benediktibk/dcconverter/circuit_designs/dc_dc_converter.asc

C1: cap; 0.01; Rser=20m
C2: cap; 2.2p
C3: cap; 1µ
C4: cap; 10n
ContactWire: voltage; PULSE(0 1000 0.01 0 0 10 10 1)
Controller: voltage; PULSE(0 3.3 0 0 0 1.5u 10u)
ControllerGate: voltage; PULSE(0 3.3 0.02 0 0 1 1)
D1: schottky; RBR30T60A
D2: diode
D3: diode
D4: zener; 1N5378B
D5: zener; 1N5378B
D6: zener; 1N5378B
D7: zener; 1N5378B
L1-710-744839010400-Mouser: ind; 1m; Rser=2.1m
Load: res; 0.576
M1: nmos
M2: pmos
M3: nmos
M7: pmos; HAT1072H
OutputGate: voltage; PULSE(0 3.3 0.0187 0 0 1 1)
Q2: npn
Q3: npn
Q4: npn
R1: res; 220
R2: res; 1Meg
R3: res; 10Meg
R4: res; 220
R5: res; 1Meg
R6: res; 10k
R8: res; 220
R14: res; 900k
R15: res; 100k
Z1: NIGBT; irg4ph50s
Named nets: 0
.tran 0.1 startup
.inc irg4ph50s.spi
.inc sct2280ke.spi
.inc FQB1P50.spi
.inc FDPF3N50NZ.spi
.inc FQP3P50.spi
.inc C2M0280120D.spi
.inc OptiMOS3_250V_LTSpice.spi
.inc FDH15N50.spi
