benediktibk/dcconverter/circuit_designs/voltage_source_driver.asc

C2: cap; 100µ
ContactWire2: voltage; PULSE(0 300 0.1 0 0 10 10 1)
D3: diode; RR601BM4S
M2: nmos; STW11NM80
R1: res; 4700
R3: res; 10Meg
Named nets: 0
.tran 0 1 0 1u
