benediktibk/dcconverter/circuit_designs/high_side_switch.asc

M1: pmos; IRF7205
Q1: npn
R1: res; 10
R2: res; 220
R3: res; 1k
V1: voltage; 24
V2: voltage; PULSE(0 5 0.5 0 0 10 10)
Named nets: 0
.tran 5
