benediktibk/dcconverter/circuit_designs/recitifier.asc

C1: cap; 10m
C2: cap; 10m
D1: diode; RR1LAM6S
D2: diode; RR1LAM6S
D3: diode; RR1LAM6S
D4: diode; RR1LAM6S
D5: diode; RR1LAM6S
R1: res; 100m; pwr=1W
R2: res; 100
V1: voltage; SINE(0 325 50)
Named nets: 0
.tran .5
