benediktibk/dcconverter/circuit_designs/driver_prototype.asc

C1: cap; 550pF
Q1: npn; 2N2222
Q2: npn; 2N2222
Q3: npn; 2N2222
R1: res; 4.7k
R2: res; 220
R3: res; 4.7k
R4: res; 220
R5: res; 220
V1: voltage; 10
V2: voltage; PULSE(0 3.3 0.5 0 0 1 2)
V3: voltage; PULSE(0 3.3 5 0 0 5 10)
Named nets: 0
.tran 10
