benediktibk/dcconverter/circuit_designs/controller.asc

C4: cap; 2.2nF
ControllerVoltage1: voltage; PULSE(2.4 3 1m 1u 1u 1m 2m)
ControllerVoltage: voltage; 5
M8: nmos
M9: pmos
Q2: pnp; 2N3906
R2: res; 3k
R12: res; 680
R13: res; 1k
R16: res; 73k
U1: NE555
Named nets: 0
.tran 10m startup
