benediktibk/dcconverter/circuit_designs/igbt_gate_driver.asc

C1: cap; 1µ; Rser=1m
C2: cap; 1µ; Rser=1m
C3: cap; 1µ; Rser=1m
M1: nmos
M2: pmos
M3: nmos
M4: pmos
M5: nmos
M6: pmos
M7: nmos
M8: nmos
R1: res; 100
R3: res; 100
U1: 4N25
U2: 4N25
V1: voltage; 5
V2: voltage; PULSE(0 5 1 0 0 2 5)
V3: voltage; 100
V4: voltage; PULSE(0 5 1 0 0 2 5)
V5: voltage; 5
V6: voltage; 100
V7: voltage; PULSE(0 5 1 0 0 2 5)
V8: voltage; 5
Named nets: 0
.tran 20
