benediktibk/dcconverter/DcConverterControllerOptimization/CircuitSimulation/StepDownConverterRealisticValues.asc

C1: cap; 100µ
Controller: voltage; PULSE(0 17.7 0 0.001u 0.001u 0.1 0.1)
L1: ind; 0.002; Rser=0.4
Load: res; 10
Named nets: 0
.tran 0 10MS 0 1NS
.OPTIONS TRTOL=1
