benediktibk/dcconverter/DcConverterControllerOptimization/ConverterSimulationTest/StepDownConverterVersion1.asc

C1: cap; 100µ
Controller1: voltage; PULSE(0 -0.67 0 1n 1n 100m 100m)
Controller: voltage; PULSE(0 18.37 0 0.01u 0.01u 20u 134u)
L1: ind; 0.002; Rser=0.4
Load: res; 10
Named nets: 0
.tran 0 50MS 0 10NS
