benediktibk/dcconverter/DcConverterControllerOptimization/CircuitSimulation/StepDownConverter.asc

C1: cap; 220m
L1: ind; 900m
R1: res; 2
R2: res; 0.2
V1: voltage; PULSE(2.2 10 0 0.001 0.001 0.2 5)
Named nets: 0
.tran 0 5 0 0.0001
