benediktibk/dcconverter/DcConverterControllerOptimization/CircuitSimulation/ResistorInSeriesAndCapacitor.asc

C1: cap; 0.3
R1: res; 2
R2: res; 3
V1: voltage; PULSE(5 10 0 0)
Named nets: 0
.tran 0 5 0 0.01
