benediktibk/dcconverter/DcConverterControllerOptimization/CircuitSimulation/ResistorInSeriesAndInductance.asc

L1: ind; 900m
R1: res; 2
R2: res; 3
V1: voltage; PULSE(0 10 0 0)
Named nets: 0
.tran 0 5 0 0.001
