benediktibk/dcconverter/DcConverterControllerOptimization/CircuitSimulation/ResistorInSeries.asc

R1: res; 2
R2: res; 3
V1: voltage; 10
Named nets: 0
.tran 5
