benediktibk/dcconverter/pcbs/dcconverter/dcconverter.kicad_pcb

## KiCad design pcbs/dcconverter/dcconverter.kicad_pcb (2020-11-22)

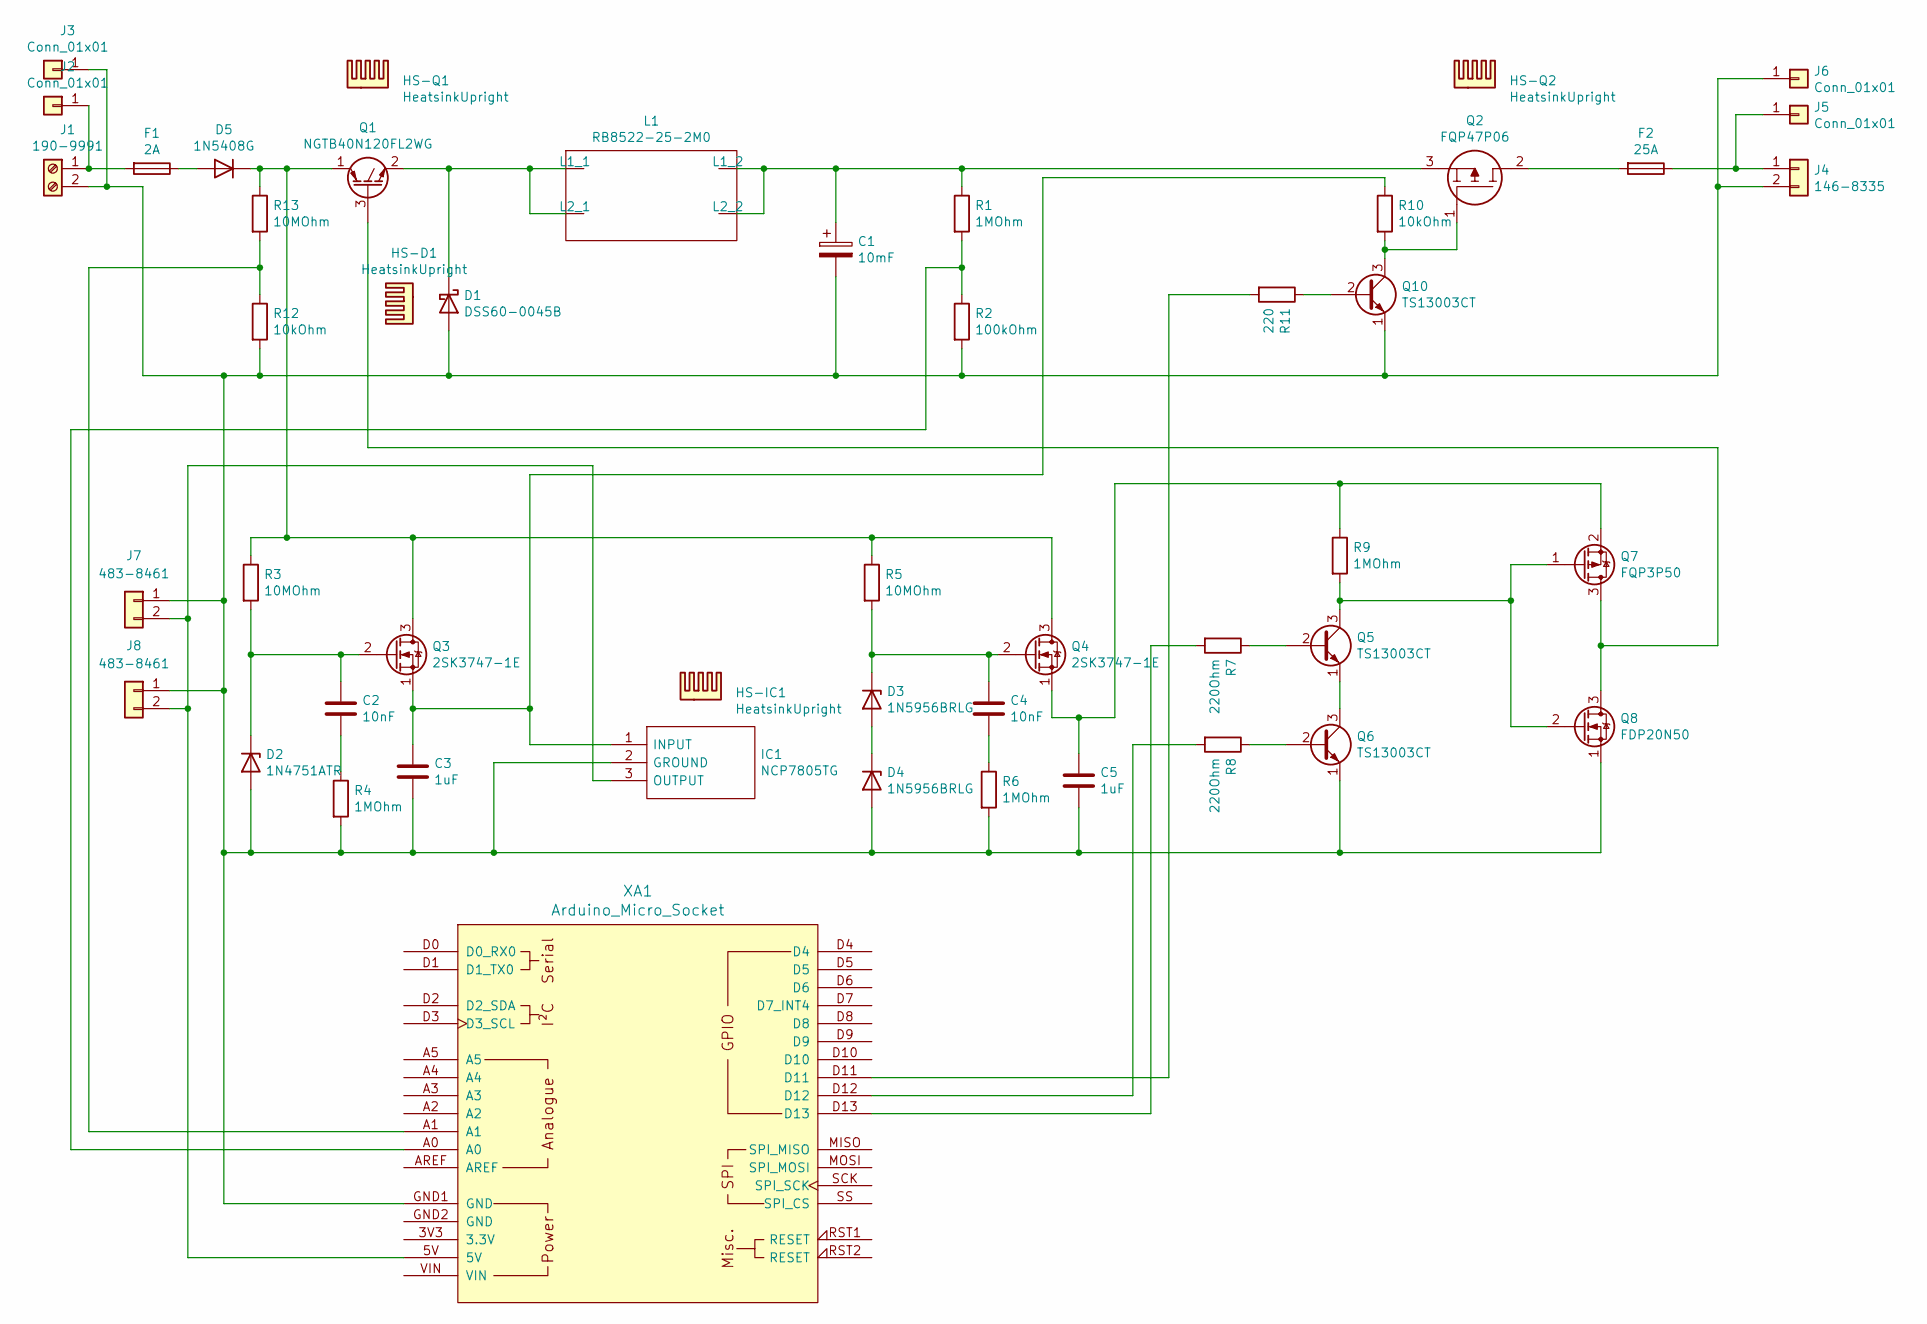
[picture p1: schematic dcconverter.sch]

Parts:
C1: 10mF; CAPPRD1250W100D2550H5200
C2, C4: 10nF; C_Disc_D14.5mm_W5.0mm_P7.50mm
C3, C5: 1uF; CP_Radial_D8.0mm_P2.50mm
D1: DSS60-0045B; DSS60-0045B_Vertical
D2: 1N4751ATR; D_DO-41_SOD81_P10.16mm_Horizontal
D3, D4: 1N5956BRLG; D_DO-41_SOD81_P10.16mm_Horizontal
D5: 1N5408G
F1: 2A; Fuseholder_Cylinder-5x20mm_Schurter_0031_8201_Horizontal_Op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
F2: 25A; Fuseholder_Cylinder-5x20mm_Schurter_0031_8201_Horizontal_Op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
HS-D1: HeatsinkUpright
HS-IC1: HeatsinkUpright
HS-Q1, HS-Q2: HeatsinkUpright
IC1: NCP7805TG; TO-220-3_Vertical; Manufacturer_Part_Number NCP7805TG
J1: 190-9991; TerminalBlock_2pin_10mm
J2, J3, J5, J6: Conn_01x01; SLB4-I90
J4: 146-8335; connector_2pin_P10.6mm
J7, J8: 483-8461; Molex_KK_254_2pin
L1: RB8522-25-2M0; rb8522_size5
Q1: NGTB40N120FL2WG; NGTB40N120FL2WG_Vertical
Q2: FQP47P06; FQP47P06_Vertical_Wide; Manufacturer_Part_Number FQP47P06
Q3, Q4: 2SK3747-1E; 2SK3747_TabDown
Q5, Q6, Q10: TS13003CT; TS13003CT_wide
Q7: FQP3P50; FQP3P50_Horizontal_TabDown
Q8: FDP20N50; FDP20N50_Horizontal_TabDown
R1, R4, R6, R9: 1MOhm; R_Axial_DIN0207_L6.3mm_D2.5mm_P10.16mm_Horizontal
R2: 100kOhm; R_Axial_DIN0207_L6.3mm_D2.5mm_P10.16mm_Horizontal
R3, R5, R13: 10MOhm; R_Axial_DIN0207_L6.3mm_D2.5mm_P10.16mm_Horizontal
R7, R8: 220Ohm; R_Axial_DIN0207_L6.3mm_D2.5mm_P10.16mm_Horizontal
R10, R12: 10kOhm; R_Axial_DIN0207_L6.3mm_D2.5mm_P10.16mm_Horizontal
R11: 220; R_Axial_DIN0207_L6.3mm_D2.5mm_P10.16mm_Horizontal
XA1: Arduino_Micro_Socket

Connections:
unnamed: C1.1, L1.3 (L1_2), L1.4 (L2_2), Q2.3, R1.1
unnamed: C1.2, C3.2, C5.2, D1.2 (A), D2.2 (A), D4.2 (A), IC1.2 (GROUND), J1.2, J3.1, J4.2, J6.1, J7.1, J8.1, Q6.1 (E), Q8.1 (S), Q10.1 (E), R2.2, R4.2, R6.2, R12.2, XA1.GND1 (GND)
unnamed: C2.1, D2.1 (K), Q3.2 (G), R3.2
unnamed: C2.2, R4.1
unnamed: C3.1, IC1.1 (INPUT), Q3.1 (S), R10.1
unnamed: C4.1, D3.1 (K), Q4.2 (G), R5.2
unnamed: C4.2, R6.1
unnamed: C5.1, Q4.1 (S), Q7.2 (S), R9.1
unnamed: D1.1 (K), L1.1 (L1_1), L1.2 (L2_1), Q1.2 (E)
unnamed: D3.2 (A), D4.1 (K)
unnamed: D5.1 (K), Q1.1 (C), Q3.3 (D), Q4.3 (D), R3.1, R5.1, R13.1
unnamed: D5.2 (A), F1.1
unnamed: F1.2, J1.1, J2.1
unnamed: F2.1, J4.1, J5.1
unnamed: F2.2, Q2.2
unnamed: IC1.3 (OUTPUT), J7.2, J8.2, XA1.5V
unnamed: Q1.3 (G), Q7.3 (D), Q8.3 (D)
unnamed: Q5.1 (E), Q6.3 (C)
unnamed: Q5.2 (B), R7.1
unnamed: Q5.3 (C), Q7.1 (G), Q8.2 (G), R9.2
unnamed: Q6.2 (B), R8.1
unnamed: Q10.2 (B), R11.1
unnamed: Q2.1, Q10.3 (C), R10.2
unnamed: R1.2, R2.1, XA1.A0
unnamed: R7.2, XA1.D13
unnamed: R8.2, XA1.D12
unnamed: R11.2, XA1.D11
unnamed: R12.1, R13.2, XA1.A1

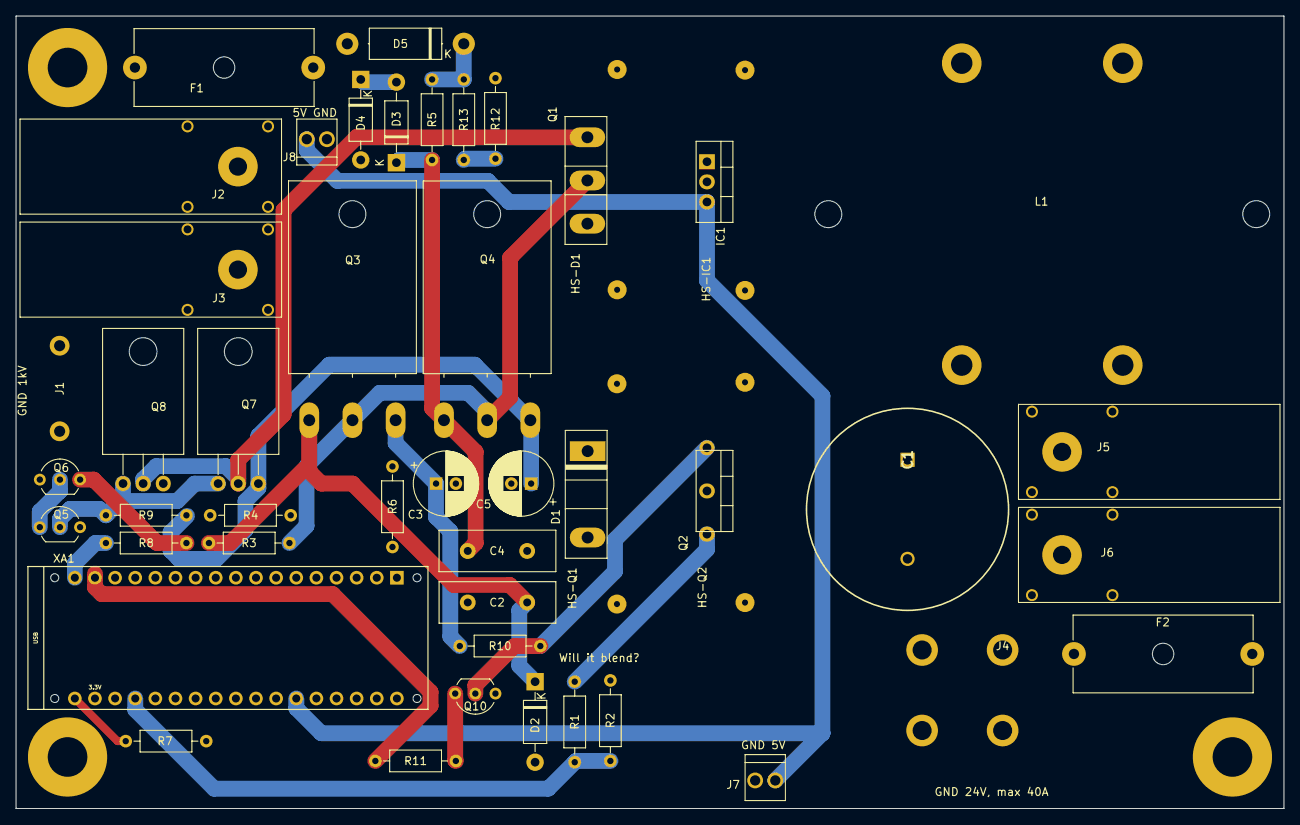
[picture p2: board dcconverter.kicad_pcb from above]

Board: 4 copper layers, 160.0 x 100.0 mm, 49 parts (0 on the bottom side), 28 nets.
