benediktibk/dcconverter/pcbs/rectifier/rectifier.kicad_pcb

## KiCad design pcbs/rectifier/rectifier.kicad_pcb (2020-10-14)

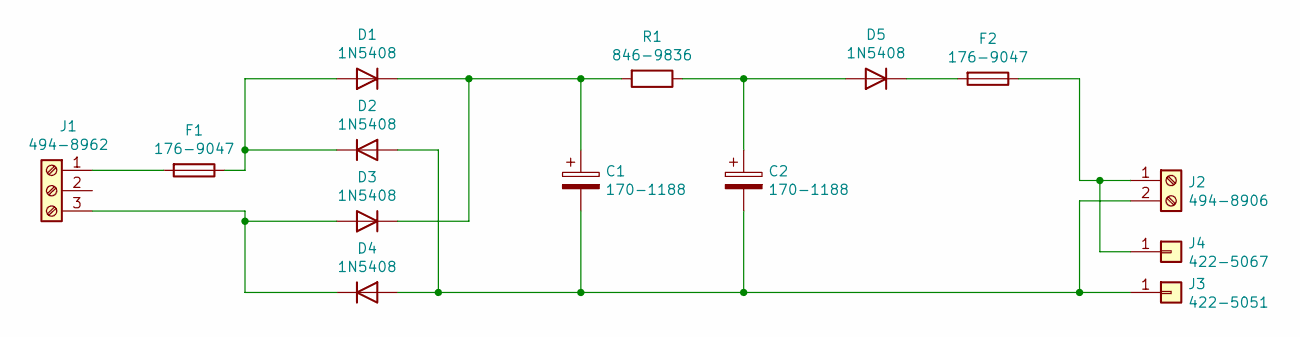
[picture p3: schematic rectifier.sch]

Parts:
C1, C2: 170-1188; CP_Radial_D18.0mm_P7.50mm
D1, D2, D3, D4, D5: 1N5408; D_DO-201AD_P15.24mm_Horizontal
F1, F2: 176-9047; Fuseholder_Cylinder-5x20mm_Schurter_0031_8201_Horizontal_Op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
J1: 494-8962; TerminalBlock_Altech_AK300-3_P5.00mm
J2: 494-8906; TerminalBlock_Altech_AK300-2_P5.00mm
J3: 422-5051; SLB4-I90
J4: 422-5067; SLB4-I90
R1: 846-9836; R_Axial_DIN0414_L11.9mm_D4.5mm_P15.24mm_Horizontal

Connections:
unnamed: C1.1, D1.1 (K), D3.1 (K), R1.2
unnamed: C1.2, C2.2, D2.2 (A), D4.2 (A), J2.2, J3.1
unnamed: C2.1, D5.2 (A), R1.1
unnamed: D1.2 (A), D2.1 (K), F1.1
unnamed: D3.2 (A), D4.1 (K), J1.3
unnamed: D5.1 (K), F2.2
unnamed: F1.2, J1.1
unnamed: F2.1, J2.1, J4.1

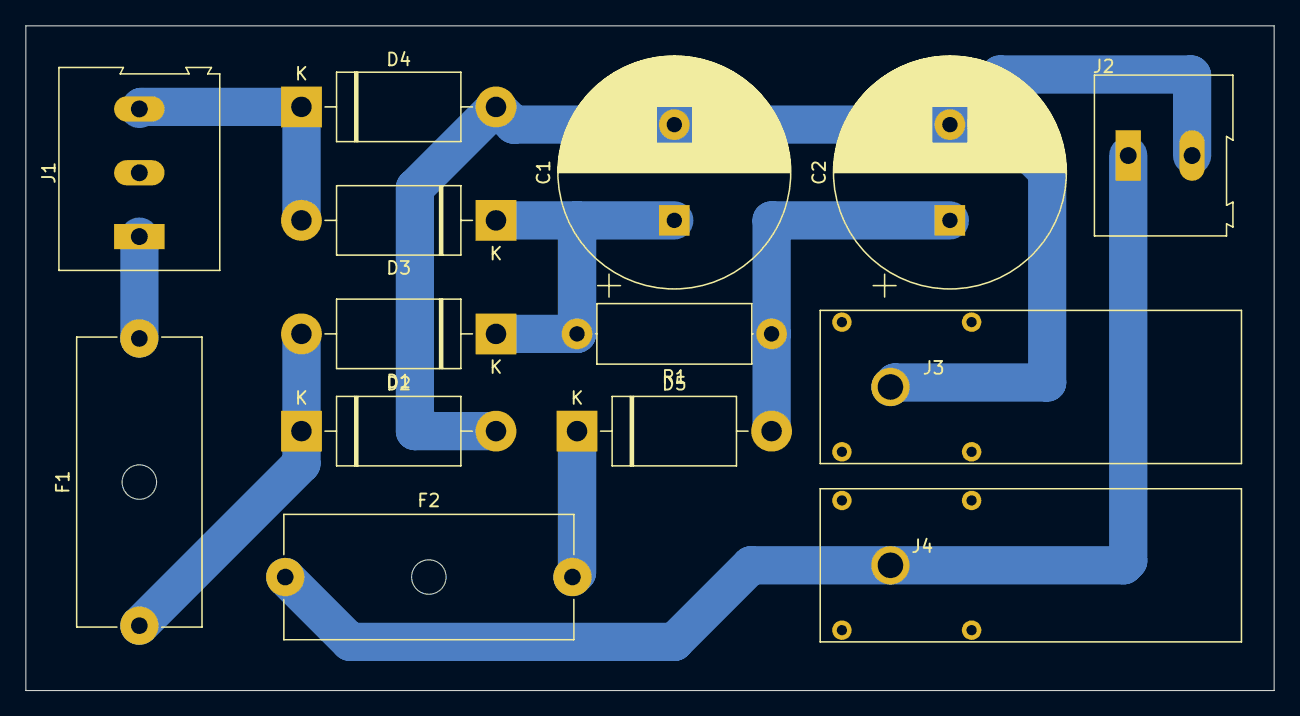
[picture p4: board rectifier.kicad_pcb from above]

Board: 2 copper layers, 97.8 x 52.1 mm, 14 parts (0 on the bottom side), 8 nets.
