benediktibk/dcconverter/DcConverterControllerOptimization/CircuitSimulationTest/testdata/StepDownConverterRealisticValues.csv

0.000000000000000E+000 | 0.000000E+000
4.681142774996619E-011 | -2.527390E-014
9.362285549993238E-011 | 7.805953E-015
1.404342832498986E-010 | 9.923956E-014
1.872457109998648E-010 | 2.490269E-013
2.340571387498310E-010 | 4.571680E-013
2.808685664997972E-010 | 7.236629E-013
3.276799942497632E-010 | 1.048512E-012
6.553599884995265E-010 | 6.128491E-012
1.000000000000000E-009 | 1.539270E-011
1.438669120050922E-007 | 9.102678E-007
2.867338240101844E-007 | 3.625801E-006
4.296007360152766E-007 | 8.146616E-006
5.724676480203687E-007 | 1.447271E-005
7.153345600254608E-007 | 2.260409E-005
8.582014720305531E-007 | 3.254075E-005
1.001068384035645E-006 | 4.428269E-005
1.002068384035645E-006 | 4.437123E-005
1.148211241178513E-006 | 5.826210E-005
1.294354098321381E-006 | 7.403968E-005
1.440496955464250E-006 | 9.170399E-005
1.586639812607118E-006 | 1.112550E-004
1.732782669749986E-006 | 1.326928E-004
1.878925526892854E-006 | 1.560172E-004
2.025068384035722E-006 | 1.812284E-004
2.026068384035722E-006 | 1.814074E-004
2.172211241178590E-006 | 2.085170E-004
2.318354098321458E-006 | 2.375111E-004
2.464496955464327E-006 | 2.683895E-004
2.610639812607195E-006 | 3.011523E-004
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
