benediktibk/dcconverter/measurements/converter_behaviour.xlsx

On Time [us] | Period Time [us] | Off Time [us] | Output Voltage [V] | Load Current [A] | Load [W]
1 | 1 | 0 | 107.82 | 187.2 | 20183.90
1 | 5 | 4 | 43.46 | 75.44 | 3278.62
1 | 7 | 6 | 31.08 | 53.97 | 1677.39
1 | 8 | 7 | 27.2 | 47.21 | 1284.11
1 | 9 | 8 | 24.18 | 41.99 | 1015.32
1 | 9.05 | 8.05 | 24.05 | 41.76 | 1004.33
1 | 9.07 | 8.07 | 24 | 41.67 | 1000.08
1 | 9.1 | 8.1 | 23.92 | 41.53 | 993.40
1 | 9.2 | 8.2 | 23.66 | 41.08 | 971.95
1 | 10 | 9 | 21.84 | 37.92 | 828.17
1 | 20 | 19 | 10.95 | 19.01 | 208.16
