benediktibk/dcconverter/measurements/singleshot.PNG

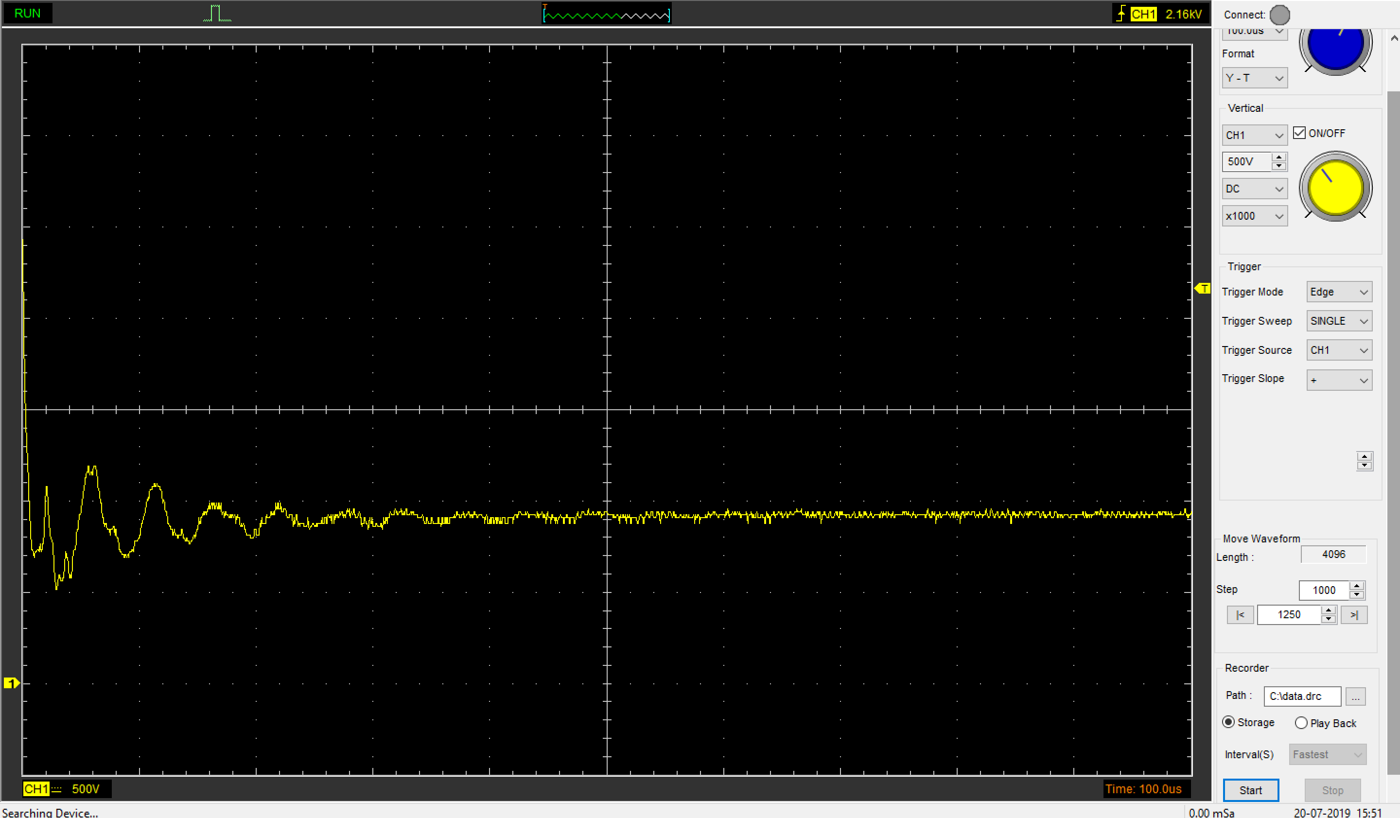
measurements/singleshot.PNG
