benediktibk/dcconverter/(commit log)

2019-03-27 Rename Schematics
2019-04-02 Add circuit sizing
    [circuit_sizing.xlsx]
2019-04-02 Add basic Arduino Project
2019-04-02 Add Example Pulse Width Modulation Circuit
2019-04-02 Add Prototype with lower Voltages
    [circuit_sizing.xlsx]
2019-04-02 Implement Controller for Low Voltage Prototype
2019-07-23 Fix formula for circuit
2019-12-02 Add Test Circuit for only resistors
2019-12-02 Add Simulation for ResistorInSeries
2019-12-02 Add Testcase for additional Capacitor
2019-12-02 Turn the input voltage into a static parameter of the circuit
2019-12-02 First try to implement the circuit with Capacitor
2019-12-03 Add Testcase for ResistorInSeriesAndInductance
2019-12-03 Implement ResistorInSeriesAndInductance
2019-12-03 Fix Tests for ResistorInSeriesAndInductance
2019-12-03 Add Test for ResistorInSeriesAndCapacitor
2019-12-03 Fix ResistorInSeriesAndCapacitor
2019-12-03 Separate aperiodic and periodic case in StepDownConverter
2019-12-03 Add Tests for sequential Circuit use
2019-12-03 Implement Gradient Calculation for aperiodic Case
2019-12-03 Implement Gradient Calculation for periodic Case
2019-12-03 Introduce Dto for Circuit Data
2019-12-04 Rename Classes and Files with the Suffix Simulator to distinguish between Circuit and Converter
2019-12-08 Add Test with complete Data Series
    [StepDownConverterRealisticValues.csv]
2019-12-08 Fix Parsing of Data Series
    [StepDownConverterRealisticValues.csv]
2019-12-08 Fix Test for CircuitSimulator
2020-09-21 Use real world values for circuit simulation
2020-09-21 Improve Driver
2020-09-21 Work on Driver
2020-09-22 Add Example circuit for IGBT Gate Driver
2020-09-22 Work on Gate Driver Circuit
2020-09-23 Implement Driver with Input Voltage of 100V
2020-09-23 Change Gate Driver to a CMOS inverter with max 500V
2020-09-23 Test Reduction of Control Voltage to 100V
2020-09-23 Use a Mosfet as the Gate Voltage Source
2020-09-23 Make it possible to control the IGBT with 20V
2020-09-23 Control the IGBT gate with 5V
2020-09-23 Separate Gate Driver
2020-09-23 Find timing setup for approximately 24 Volt output
2020-09-23 Figured out correct Timings for Controller
    [converter_behaviour.xlsx]
2020-09-23 Add Graph for Output Voltage/Period Time
    [converter_behaviour.xlsx]
2020-09-24 Fill in more realistic values for the inductance and the capacitor
2020-10-09 Implement Controller with Usage of Timer
2020-10-09 Use high speed timer
2020-10-09 Configure Timer correctly
2020-10-09 Manually write the Output Pin
2020-10-10 Use direct output OC4A instead of interrupts
2020-10-11 Invert Output on Hardware once more
    [arduino_controller.ino]
2020-10-13 Reduce maximum cumulative error
    [arduino_controller.ino]
2020-10-14 Add Circuit Design for B2 Rectifier
2020-10-14 Add PCB for Rectifier
    [rectifier-B_Cu.gbr, rectifier-B_Mask.gbr, rectifier-B_Paste.gbr, rectifier-B_SilkS.gbr, rectifier-Edge_Cuts.gbr, rectifier-F_Cu.gbr, rectifier-F_Mask.gbr, rectifier-F_Paste.gbr]
2020-10-15 Apply Knowledge learned from Prototype to Driver
2020-10-22 Simplify output high side switch
2020-10-22 Test high side switch
2020-10-22 Fix output high side switch
2020-10-22 Make minor tweaks to the Converter Circuit Design
2020-10-23 Add PCB Design for DC Converter
    [dcconverter.kicad_pcb, dcconverter.sch]
2020-10-24 Wire Two Phase Inductor differently
    [dcconverter.sch]
2020-10-24 Simplify driver for IGBT
2020-10-24 Finish Schematic for PCB
    [dcconverter.sch]
2020-10-24 Start with routing of DC Converter
    [dcconverter.sch]
2020-10-24 Finish PCB for first draft of DC Converter
    [dcconverter-B_Cu.gbr, dcconverter-B_Mask.gbr, dcconverter-B_SilkS.gbr, dcconverter-Edge_Cuts.gbr, dcconverter-F_Cu.gbr, dcconverter-F_Mask.gbr, dcconverter-F_SilkS.gbr, dcconverter-NPTH.drl]
2020-10-24 Make Tracks with a high Current as thick as possible
    [dcconverter-B_Cu.gbr, dcconverter-B_Mask.gbr, dcconverter-B_SilkS.gbr, dcconverter-Edge_Cuts.gbr, dcconverter-F_Cu.gbr, dcconverter-F_Mask.gbr, dcconverter-F_SilkS.gbr, dcconverter-NPTH.drl]
2020-10-26 Note down Todos for PCB
2020-11-03 Minor Changes
    [rectifier.sch]
2020-11-03 Cleanup Symbol Library
    [dcconverter.sch, rectifier.sch]
2020-11-03 Cleanup Schematic
    [dcconverter.sch]
2020-11-03 Update Footprints to use Custom PCB Library
    [dcconverter.sch]
2020-11-16 Reduce Startup Current of Voltage Driver
2020-11-16 Simulate higher Resistor for Gate Driver
2020-11-16 Use correct Symbol and Footprint Libraries
    [dcconverter.sch]
2020-11-16 Fix Heatsinks
    [dcconverter.sch]
2020-11-16 Fix Footprint for J1
    [dcconverter.sch]
2020-11-16 Improve Voltage Source for Gate Driver
2020-11-16 Fix Issues with Voltage Source in DC DC Converter
    [dcconverter.sch]
2020-11-20 Use correct footprint for Q10
    [dcconverter.sch]
2020-11-20 Use correct footprint for D1
    [dcconverter.sch]
2020-11-20 Use correct footprint for NGTB40N120FL2WG
    [dcconverter.sch]
2020-11-20 Use correct footprint for Q2
    [dcconverter.sch]
2020-11-20 Use correct footprint for Q8
    [dcconverter.sch]
2020-11-20 Use correct footprint for Q7
    [dcconverter.sch]
2020-11-20 Use correct footprint for Q3 and Q4
    [dcconverter.sch]
2020-11-20 Use the windings in parallel
    [dcconverter.sch]
2020-11-20 Add reverse polarity protection
    [dcconverter.sch]
2020-11-20 Add measurement of input voltage
    [dcconverter.sch]
2020-11-20 Fix minor stuff
    [dcconverter.sch]
2020-11-20 Add controller to PCB schematic
    [dcconverter.sch]
2020-11-20 Use in rectifier schematic CP symbol from custom library
    [rectifier.sch]
2020-11-20 Use footprint of banana socket from custom library in rectifier schematic
    [rectifier.sch]
2020-11-20 Add banana sockets to DC converter schematic
    [dcconverter.sch]
2020-11-20 Add missing footprints
    [dcconverter.sch]
2020-11-20 Empty PCB
    [dcconverter.kicad_pcb, dcconverter.sch]
2020-11-21 Use different Capacitor for Voltage Source
2020-11-21 Place PCB
    [dcconverter.kicad_pcb]
2020-11-21 Improve Placement
    [dcconverter.kicad_pcb]
2020-11-22 Start routing PCB
    [dcconverter.kicad_pcb]
2020-11-22 Connect everything in PCB
    [dcconverter.kicad_pcb]
2020-11-22 Add GND and power planes
    [dcconverter.kicad_pcb]
2020-11-22 Add power planes
    [dcconverter.kicad_pcb]
2020-11-22 Improve power planes
    [dcconverter.kicad_pcb]
2020-11-22 Update Plot for DC Converter
    [dcconverter-B_Cu.gbr, dcconverter-B_Mask.gbr, dcconverter-B_SilkS.gbr, dcconverter-Edge_Cuts.gbr, dcconverter-F_Cu.gbr, dcconverter-F_Mask.gbr, dcconverter-F_SilkS.gbr, dcconverter-In1_Cu.gbr]
